dropthehat/Wall-Switch-Cover/test/fixtures/v7/V7_03_Shuttle_TwoPiece_ASSEMBLY_reference.stl

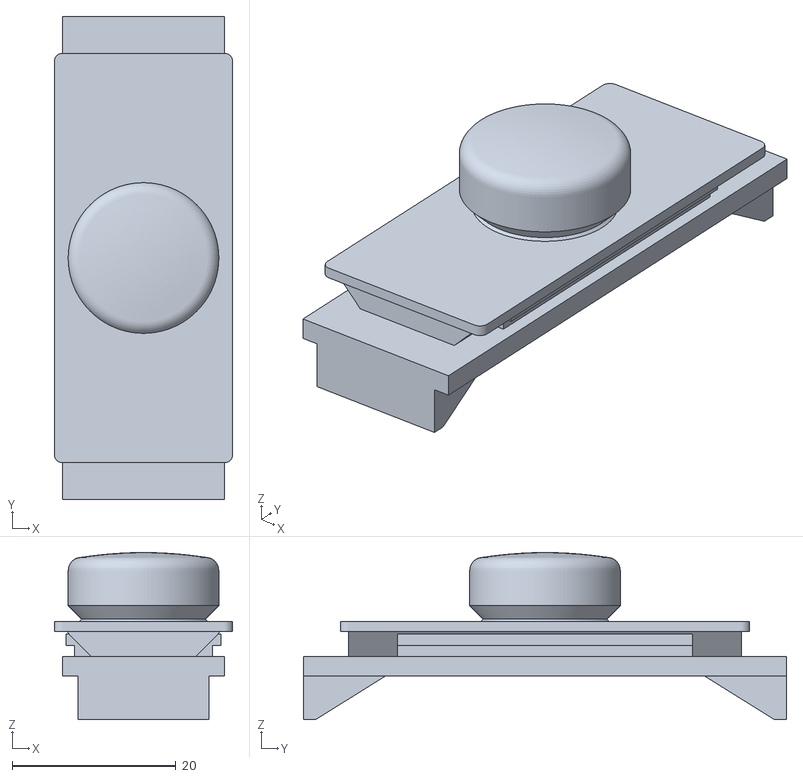
[picture p5: CAD file, 2026-11-10]
test/fixtures/v7/V7_03_Shuttle_TwoPiece_ASSEMBLY_reference.stl
21.8 x 59.0 x 20.4
