dropthehat/Wall-Switch-Cover/test/fixtures/v7/V7_03a_Shuttle_SLIDER_print_side_runner_down.stl

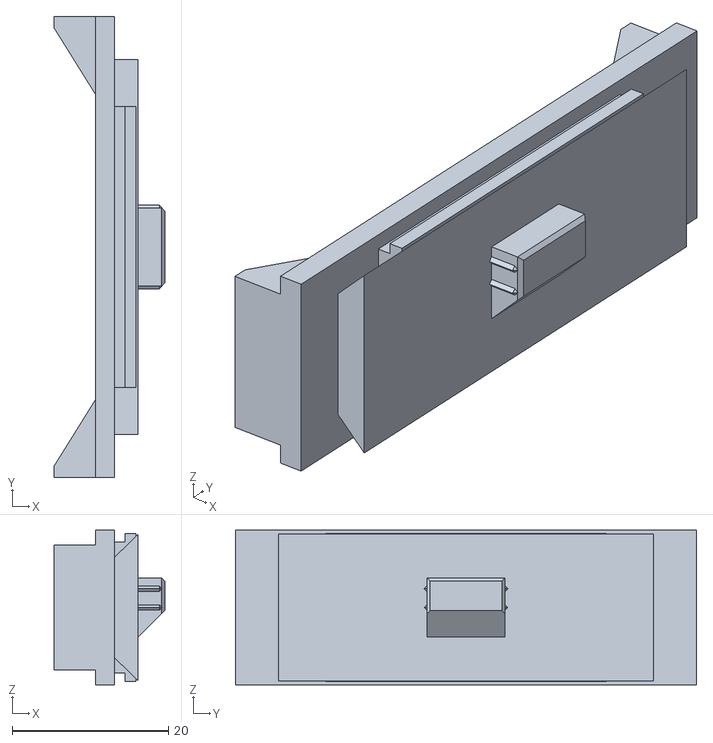
[picture p6: CAD file, 2026-11-10]
test/fixtures/v7/V7_03a_Shuttle_SLIDER_print_side_runner_down.stl
14.1 x 59.0 x 19.8
