dropthehat/Wall-Switch-Cover/test/fixtures/v7/V7_02_Cover_SolidKeepers_FINISHED_reference_face_down.stl

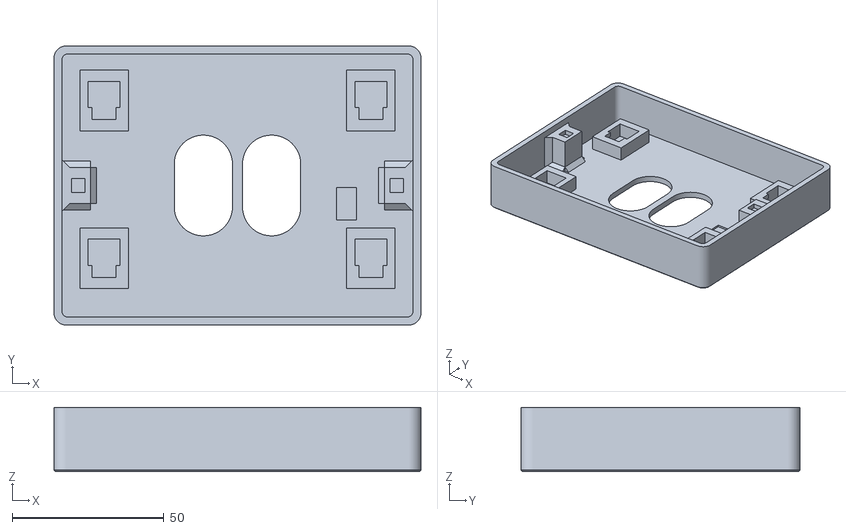
[picture p7: CAD file, 2026-11-10]
test/fixtures/v7/V7_02_Cover_SolidKeepers_FINISHED_reference_face_down.stl
121.0 x 92.0 x 21.2
