dropthehat/Wall-Switch-Cover/test/fixtures/v7/V6_04_Internal_StopGate_UNCHANGED_from_V4_rear_face_down.stl

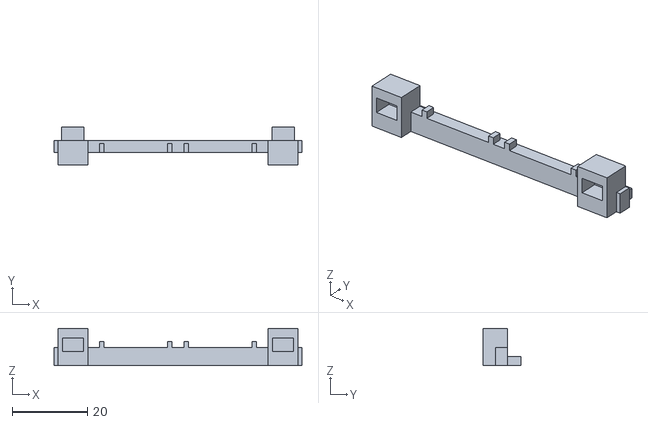
[picture p8: CAD file, 2026-11-10]
test/fixtures/v7/V6_04_Internal_StopGate_UNCHANGED_from_V4_rear_face_down.stl
66.0 x 10.0 x 9.90
