dropthehat/Wall-Switch-Cover/test/fixtures/v7/V7_03b_Shuttle_PUCK_CAP_print_FACE_UP.stl

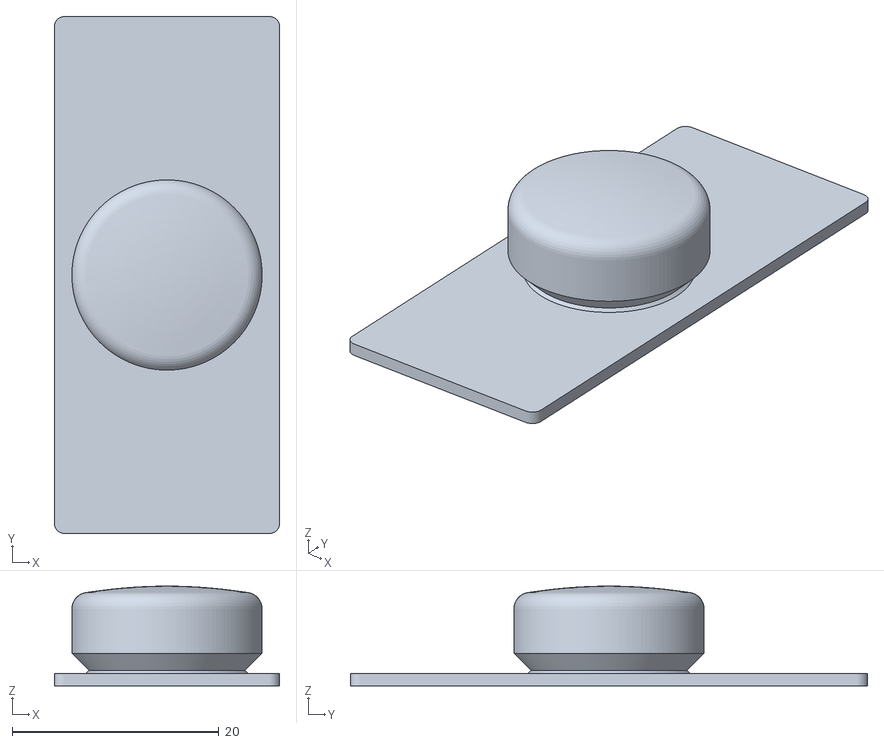
[picture p9: CAD file, 2026-11-10]
test/fixtures/v7/V7_03b_Shuttle_PUCK_CAP_print_FACE_UP.stl
21.8 x 50.0 x 9.65
