dropthehat/Wall-Switch-Cover/test/fixtures/v7/V7_02_Cover_SolidKeepers_PRINT_with_snip_ears_face_down.stl

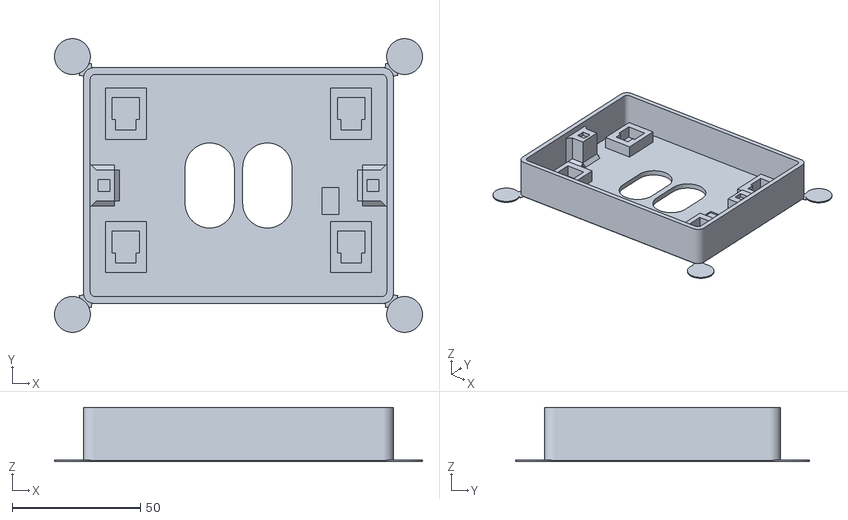
[picture p10: CAD file, 2026-11-10]
test/fixtures/v7/V7_02_Cover_SolidKeepers_PRINT_with_snip_ears_face_down.stl
143.7 x 114.7 x 21.2
