dropthehat/Wall-Switch-Cover/test/fixtures/v7/V6_01_Base_ReinforcedTrack_print_flat.stl

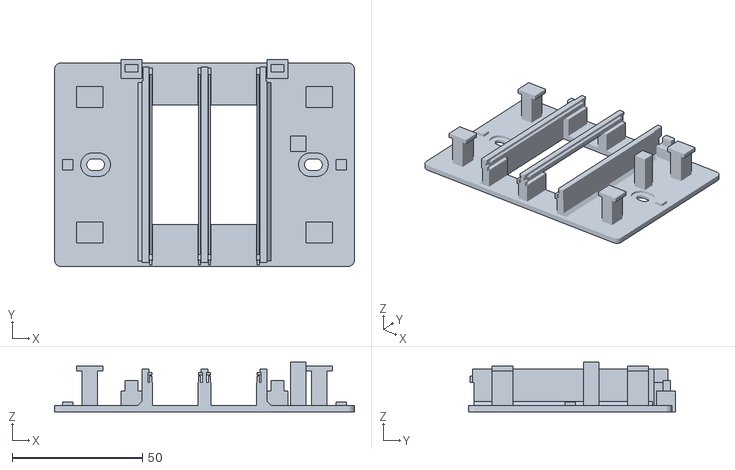
[picture p11: CAD file, 2026-11-10]
test/fixtures/v7/V6_01_Base_ReinforcedTrack_print_flat.stl
115.0 x 79.3 x 19.0
