dropthehat/Wall-Switch-Cover/(commit log)

2026-10-15 added arteor pin system
2026-10-18 ArteorCAD v25 — 1-Piece Skeleton Web, Open 2-Screw Base & Safe Magnets
2026-10-24 Use one v25 token for export names and document the studio
    STL downloads, the JSON setup file, and the suggested save name were still labeled v24. They now follow APP_VERSION, and a README describes the mounts, frame sizes, exports, and saved setups.
2026-10-24 Add Middle Eastern relief styles for switch-plate overlays
    Khatam stars, mashrabiya lattice, girih straps, and a cedar frieze
    clip to the face outline and around openings, with a mihrab crown
    and two presets. Existing mounts, tolerances, and overlay styles
    are unchanged.
2026-11-10 Add the V7 round-knob slider cover mode
    Port the validated two-module manifold kit into the studio so one to four lanes export as separate print-oriented STLs. The two-lane kit matches the reference meshes; other sizes are labelled untested.
    [V6_01_Base_ReinforcedTrack_print_flat.stl, V6_04_Internal_StopGate_UNCHANGED_from_V4_rear_face_down.stl, V7_02_Cover_SolidKeepers_FINISHED_reference_face_down.stl, V7_02_Cover_SolidKeepers_PRINT_with_snip_ears_face_down.stl, V7_03_Shuttle_TwoPiece_ASSEMBLY_reference.stl, V7_03a_Shuttle_SLIDER_print_side_runner_down.stl, V7_03b_Shuttle_PUCK_CAP_print_FACE_UP.stl]
